nendezkombet/Keeb-For-Mom/Case and build guide/PCB legend.jpg

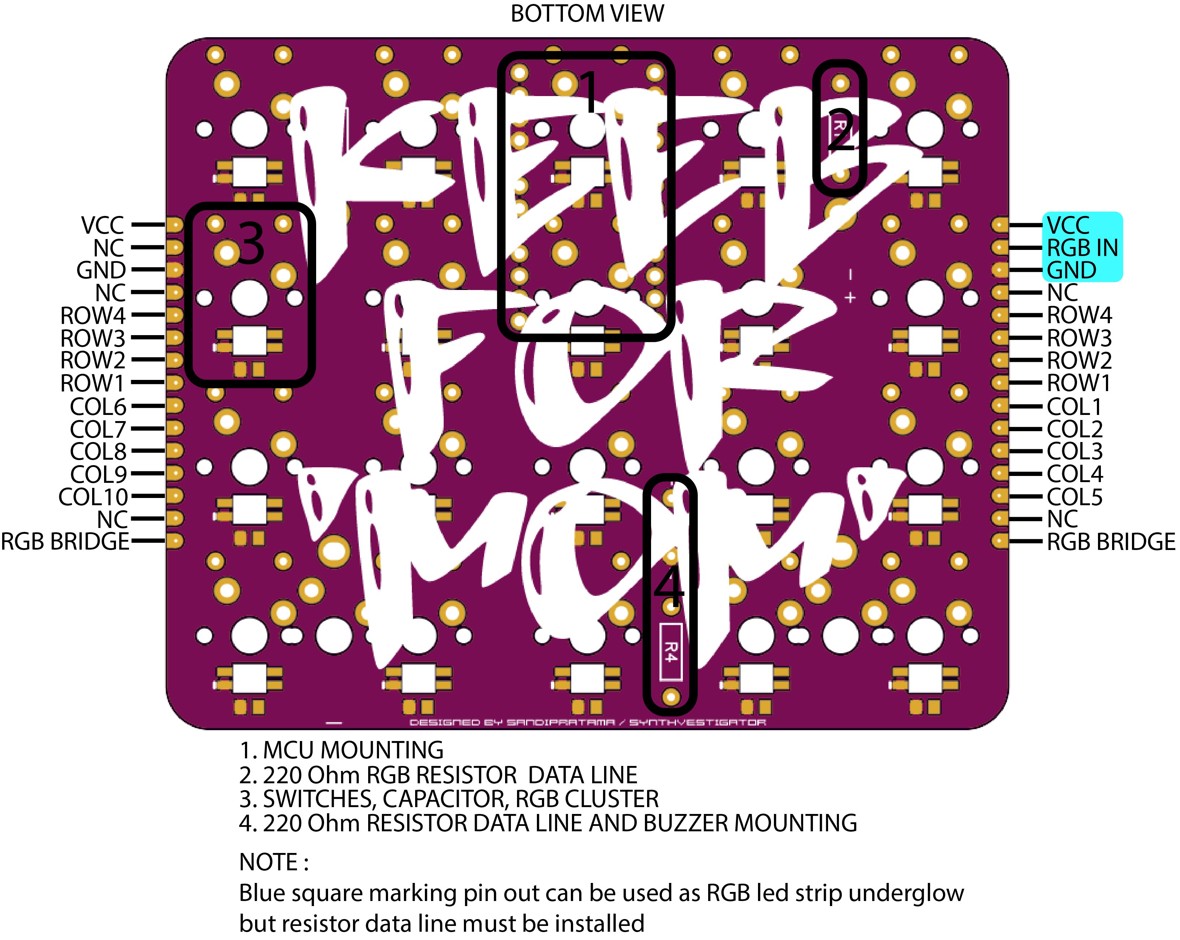
Case and build guide/PCB legend.jpg
